davidclifford/CSCvon8/VGA2/finch.png

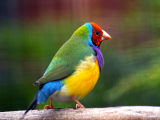
VGA2/finch.png
