davidclifford/CSCvon8/VGA2/forest-glade.png

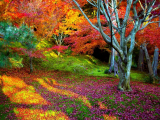
VGA2/forest-glade.png
