davidclifford/CSCvon8/VGA2/gf4.png

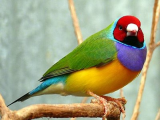
VGA2/gf4.png
