davidclifford/CSCvon8/VGA2/rainbow-cat.png

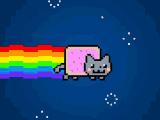
VGA2/rainbow-cat.png
