davidclifford/CSCvon8/VGA2/rainbow-cat/7cf7837815ab4ba79768796c320089a5bYWLsTBWLWjMLtxD-1.png

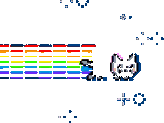
VGA2/rainbow-cat/7cf7837815ab4ba79768796c320089a5bYWLsTBWLWjMLtxD-1.png
