davidclifford/CSCvon8/VGA2/random.png

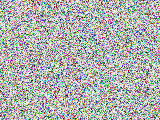
VGA2/random.png
