davidclifford/CSCvon8/VGA2/tenor.gif

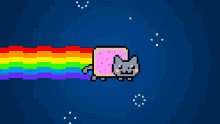
VGA2/tenor.gif
