davidclifford/CSCvon8/VGA2/trippy.png

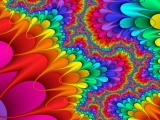
VGA2/trippy.png
