davidclifford/CSCvon8/VGA2/vga_self.png

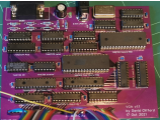
VGA2/vga_self.png
