davidclifford/CSCvon8/VGA5/cat2.gif

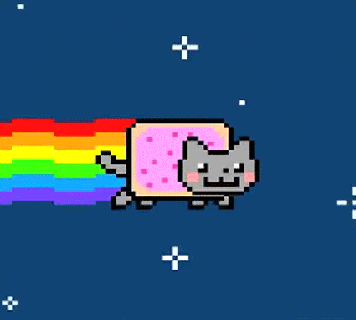
VGA5/cat2.gif
