davidclifford/CSCvon8/VGA5/cat.gif

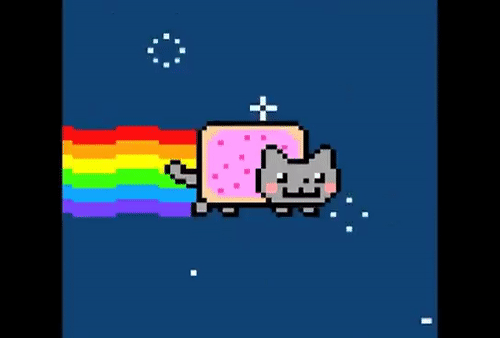
VGA5/cat.gif
