davidclifford/CSCvon8/VGA5/cookie.png

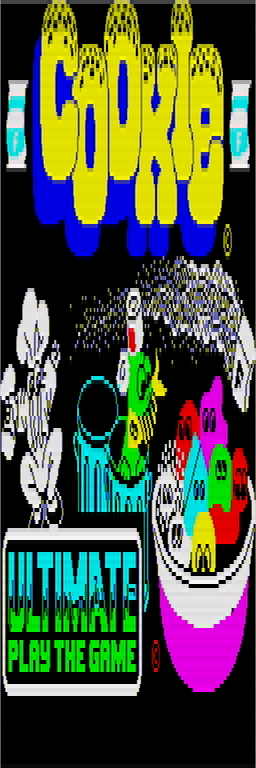
VGA5/cookie.png
