davidclifford/CSCvon8/VGA5/hobbit.png

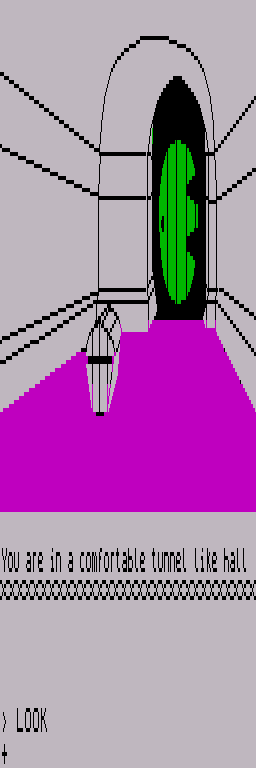
VGA5/hobbit.png
