davidclifford/CSCvon8/VGA5/the-hobbit.png

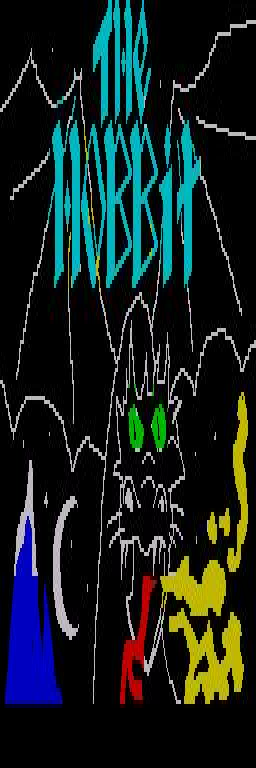
VGA5/the-hobbit.png
