davidclifford/CSCvon8/VGA5/wriggler2.png

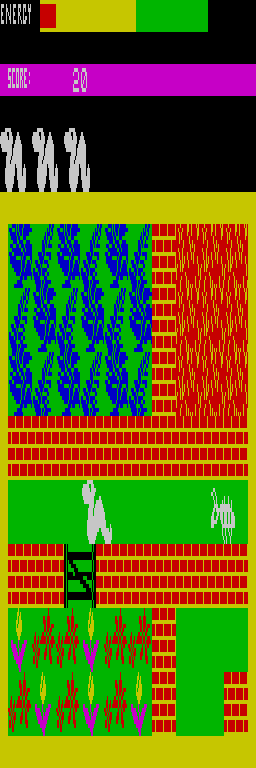
VGA5/wriggler2.png
