davidclifford/CSCvon8/VGA/3parrots.png

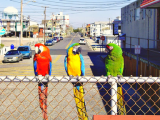
VGA/3parrots.png
