davidclifford/CSCvon8/VGA/alex-mono.png

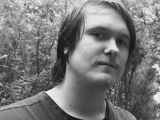
VGA/alex-mono.png
