davidclifford/CSCvon8/VGA/banana.png

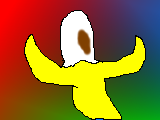
VGA/banana.png
