davidclifford/CSCvon8/VGA/breadboard_vga.jpg

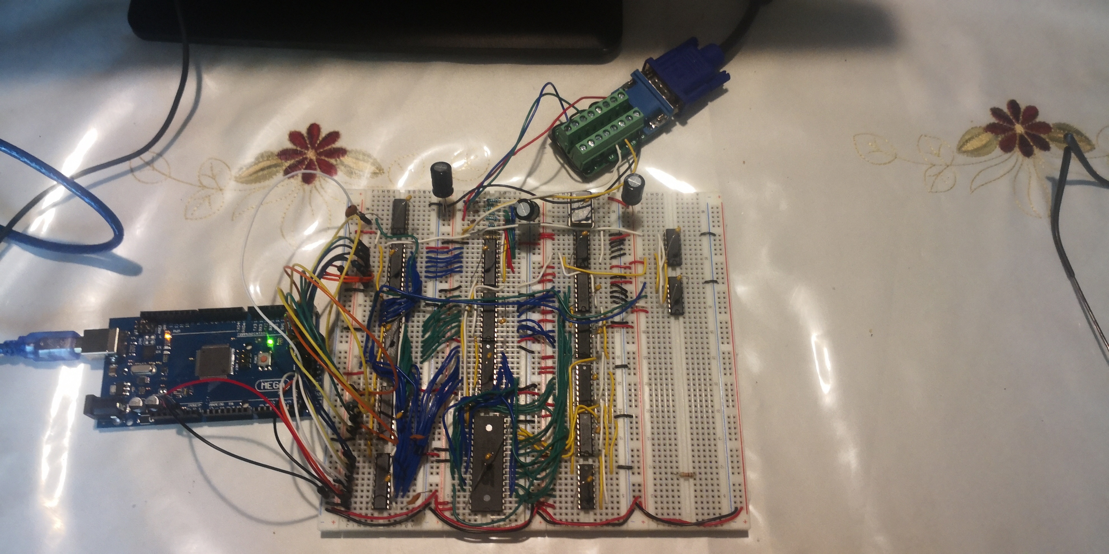
VGA/breadboard_vga.jpg
