davidclifford/CSCvon8/VGA/colours.jpg

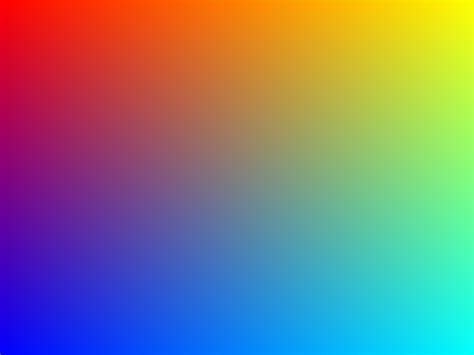
VGA/colours.jpg
