davidclifford/CSCvon8/VGA/dave.jpg

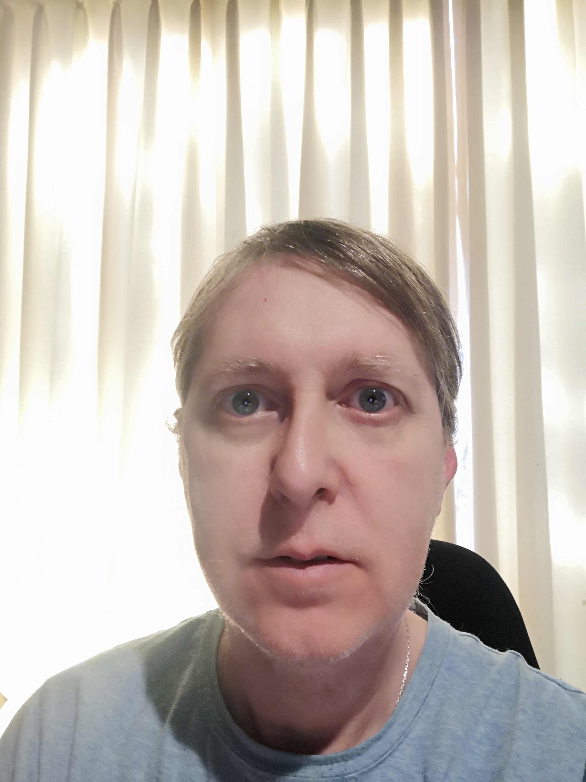
VGA/dave.jpg
