davidclifford/CSCvon8/VGA/dave.png

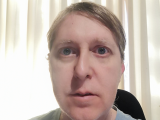
VGA/dave.png
