davidclifford/CSCvon8/VGA/gf5.jpg

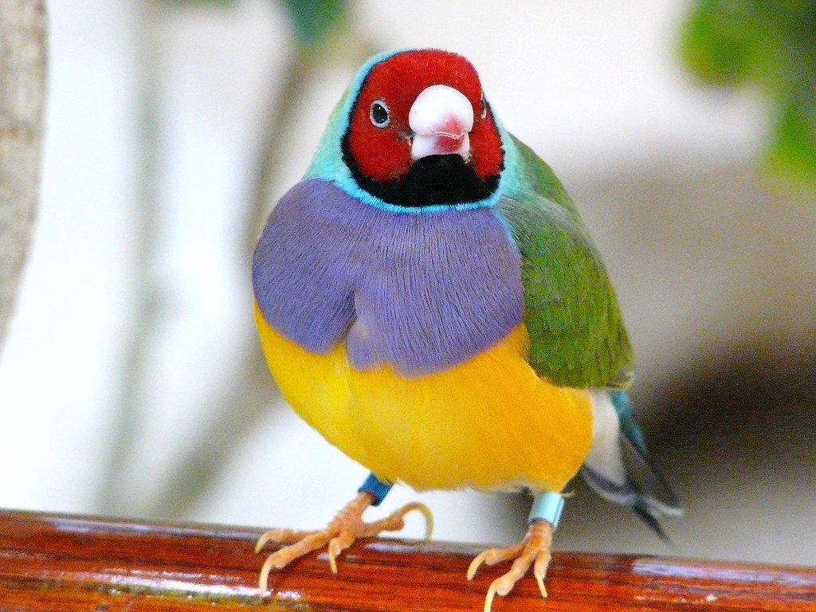
VGA/gf5.jpg
