davidclifford/CSCvon8/VGA/giga-mand.png

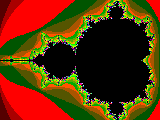
VGA/giga-mand.png
