davidclifford/CSCvon8/VGA/gigatron.png

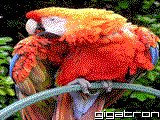
VGA/gigatron.png
