davidclifford/CSCvon8/VGA/parrot3.png

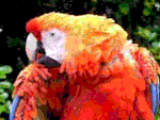
VGA/parrot3.png
