davidclifford/CSCvon8/VGA/parrot.png

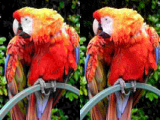
VGA/parrot.png
