davidclifford/CSCvon8/VGA/pic.png

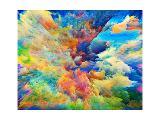
VGA/pic.png
