davidclifford/CSCvon8/VGA/rl2.png

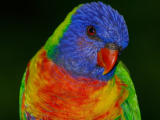
VGA/rl2.png
