davidclifford/CSCvon8/VGA/rl.png

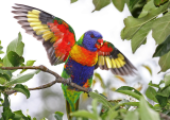
VGA/rl.png
