davidclifford/CSCvon8/VGA/Tetris_Opener.jpg

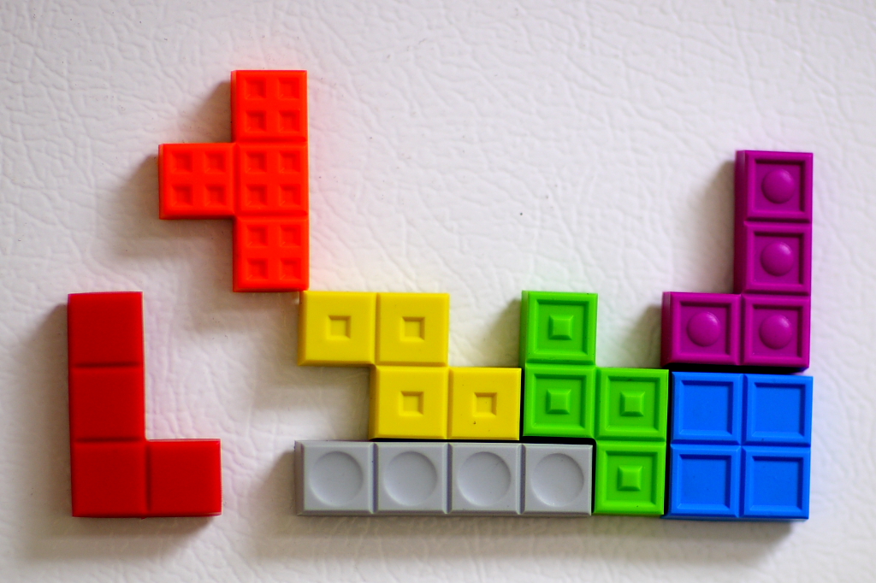
VGA/Tetris_Opener.jpg
