davidclifford/CSCvon8/VGA/vga_bb.jpg

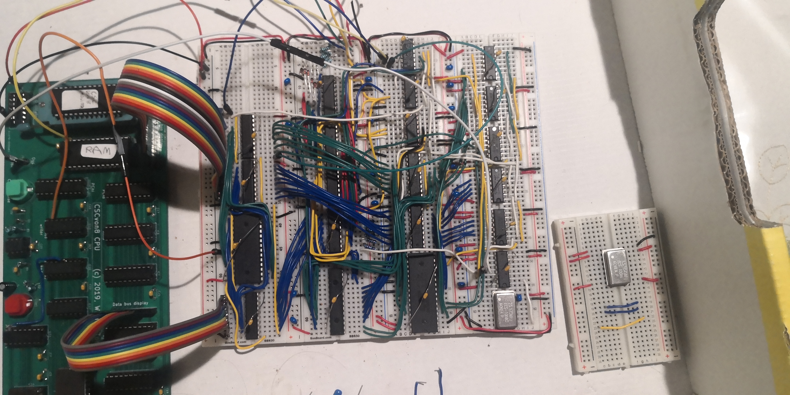
VGA/vga_bb.jpg
