davidclifford/CSCvon8/VGA/vga_bb.png

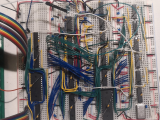
VGA/vga_bb.png
