davidclifford/CSCvon8/VGA2/BOM_PCB_VGA with RAM_2021-09-06.csv

ID | Name | Designator | Footprint | Quantity | Manufacturer Part | Manufacturer | Supplier | Supplier Part | Price
1 | 100n | C1,C2,C3,C4,C5,C6,C7,C8,C9,C10,C11,C12,C14,C15,C16,C17,C18,C19,C20,C21,C22 | RAD-0.1 | 21
2 | 100u | C13 | CAP-D10.0×F5.0 | 1
3 | 1-1734530-3 | DSUB1 | DSUB-15P-22.0X30.8-H12.5-TE | 1 | 1-1734530-3 | TE Connectivity | LCSC | C306051 | 2.015
4 | Address Bus | H1 | HDR-F-2.54_1X16 | 1 |  |  | LCSC | C66987 | 0.095
5 | Data Bus | H2 | HDR-F-2.54_1X8 | 1 |  |  | LCSC | C225505 | 0.155
6 | Pwr + Ctrl | H3 | HDR-F-2.54_1X6 | 1 |  |  | LCSC | C40877 | 0.059
7 | 1.5K | R1,R3,R5 | RES-TH_BD2.3-L6.5-P10.50-D0.5 | 3 | RN1/2WS1.5KΩFT/BA1 | TyoHM | LCSC | C385434 | 0.011
8 | 750 | R2,R4,R6 | RES-TH_BD2.2-L6.5-P10.50-D0.6 | 3 | CF1/4W-750Ω±5% T52 | CCO | LCSC | C120052 | 0.005
9 | 68 | R7,R8 | RES-TH_BD2.4-L6.3-P10.30-D0.6 | 2 | RD 1/4W 68R J T/B A1 | TyoHM | LCSC | C433699 | 0.007
10 | 74HCT163 Master clock | U1 | DIP16 | 1
11 | 74HCT161 X count low | U2 | DIP16 | 1
12 | 74HCT161 X count high | U3 | DIP16 | 1
13 | 74HCT161 Y count low | U4 | DIP16 | 1
14 | 74HCT161 Y count mid | U5 | DIP16 | 1
15 | 74HCT161 Y count high | U6 | DIP16 | 1
16 | SN74LS173AN | U17 | DIP16 | 1
17 | 39SF010 Control ROM | U7 | DIP32-600 | 1
18 | 39SF010 Pixel Control ROM | U18 | DIP32-600 | 1
19 | 74HCT245 Y count buffer | U8 | DIP-20_L25.5-W10.0-P2.54-LS7.6-BL | 1 | SN74LS245N | Texas Instruments | LCSC | C352966 | 0.661
20 | 74HCT245 X count buffer | U10 | DIP-20_L25.5-W10.0-P2.54-LS7.6-BL | 1 | SN74LS245N | Texas Instruments | LCSC | C352966 | 0.661
21 | DM74LS574N Pixel | U9 | DIP20 | 1
22 | 74HCT574 Y coord reg | U12 | DIP20 | 1
23 | 74HCT574 X coord reg | U13 | DIP20 | 1
24 | 74HCT574 Pixel reg | U14 | DIP20 | 1
25 | DM74LS574N Background | U19 | DIP20 | 1
26 | 71256SA15TPG Video mem | U11 | DIP28-300 | 1
27 | 71256SA15TPG Alt Video mem | U21 | DIP28-300 | 1
28 | 74HCT04 Inverter | U15 | DIP-14_L19.0-W7.0-P2.54-LS7.6-BL | 1 | SN74HCT04N | TI | LCSC | C50939 | 0.197
29 | 74HCT32 OR | U16 | DIP-14_L19.0-W7.0-P2.54-LS7.6-BL | 1 | SN74HC32N | TI | LCSC | C2894 | 0.282
30 | 2.1MMJACKTHM | U20 | PJ-102A | 1
31 | 27.175MHz | X1 | OSCILLATOR_DIP-14 | 1
