davidclifford/CSCvon8/VGA/8bit-testcard.jpg

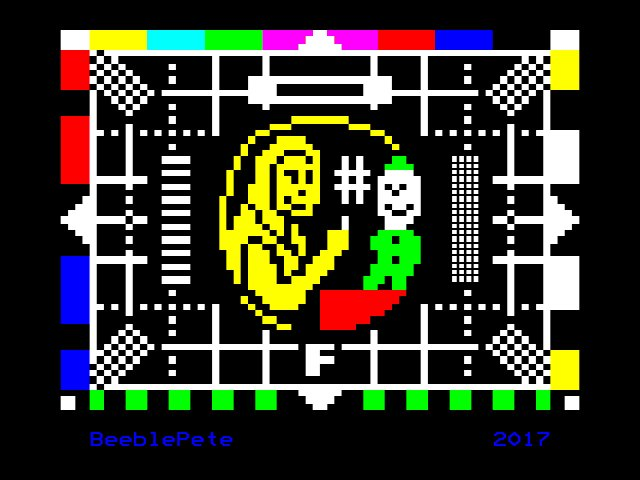
VGA/8bit-testcard.jpg
