davidclifford/CSCvon8/VGA/test.png

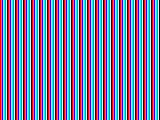
VGA/test.png
