davidclifford/CSCvon8/VGA/testcard.jpg

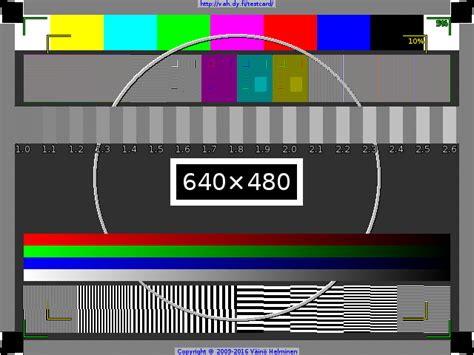
VGA/testcard.jpg
