davidclifford/CSCvon8/VGA2/Schematic_VGA with RAM.pdf

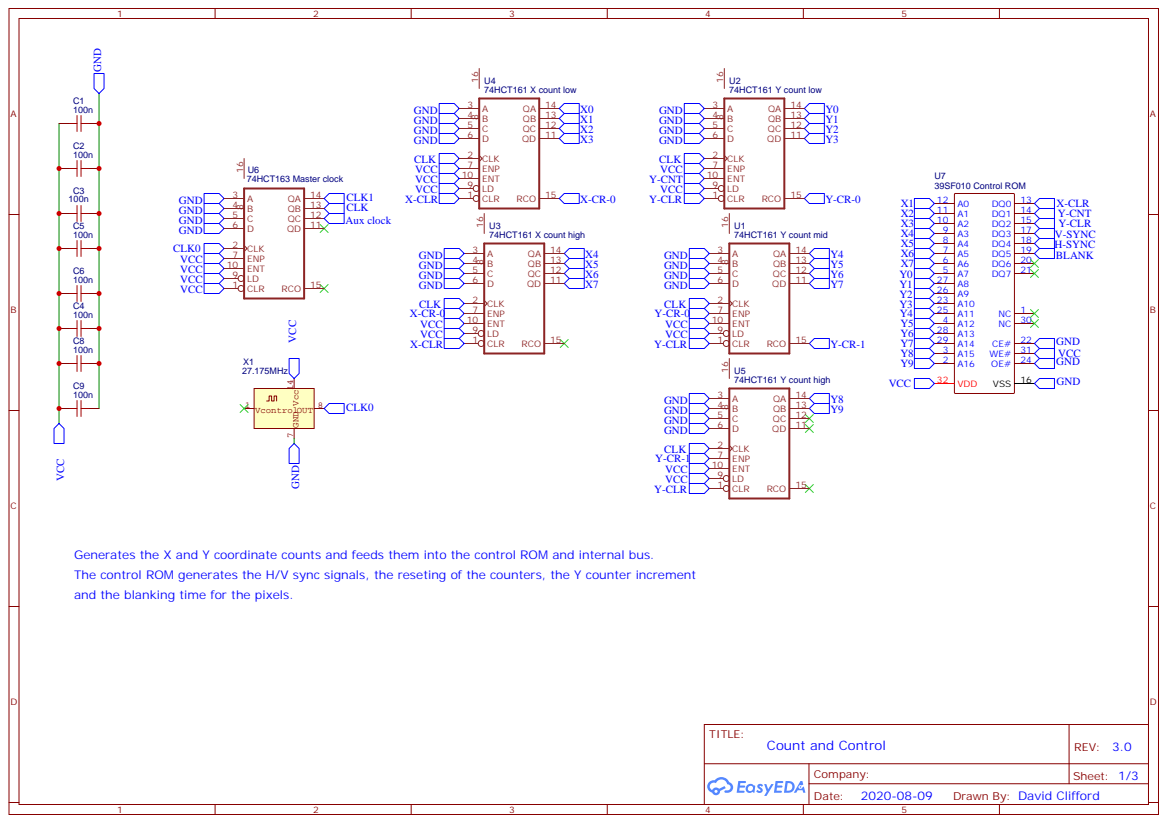
[picture p74: page 1]

Generates the X and Y coordinate counts and feeds them into the control ROM and internal bus.
The control ROM generates the H/V sync signals, the reseting of the counters, the Y counter increment
and the blanking time for the pixels.

Drawn By: David Clifford

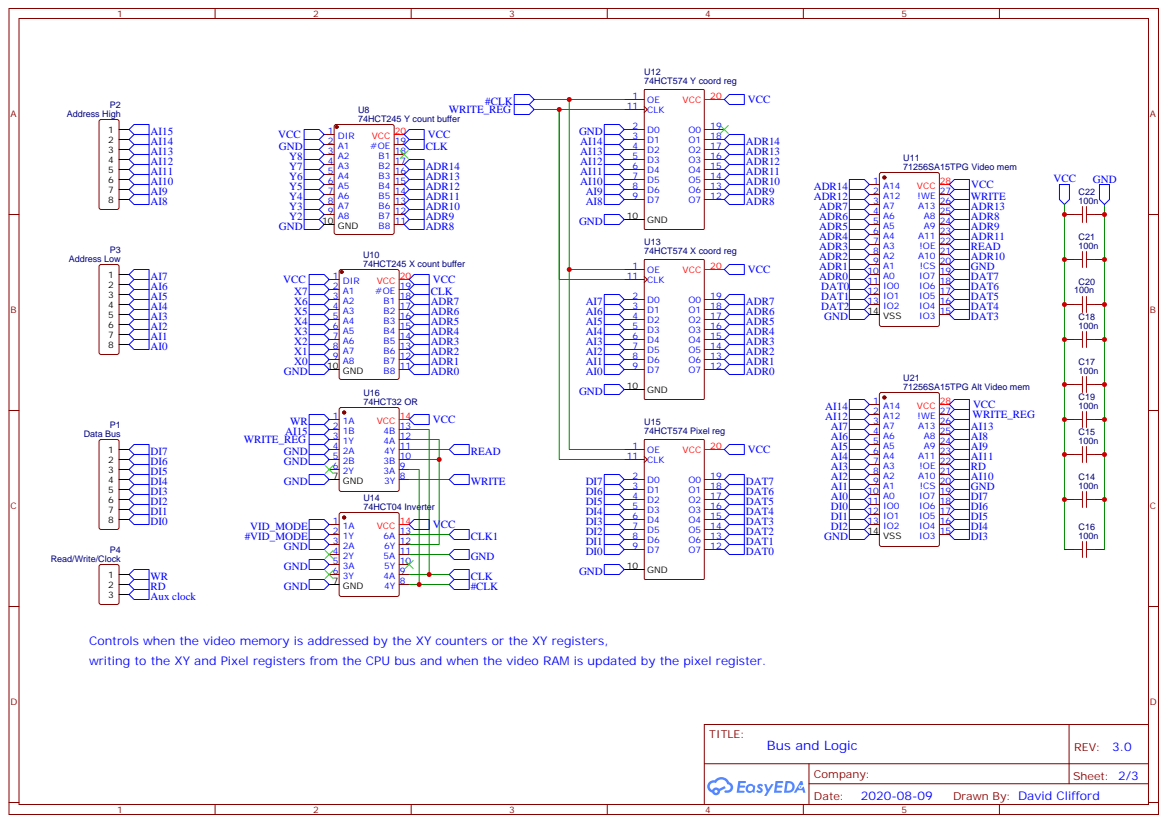
[picture p75: page 2]

Controls when the video memory is addressed by the XY counters or the XY registers,
writing to the XY and Pixel registers from the CPU bus and when the video RAM is updated by the pixel register.

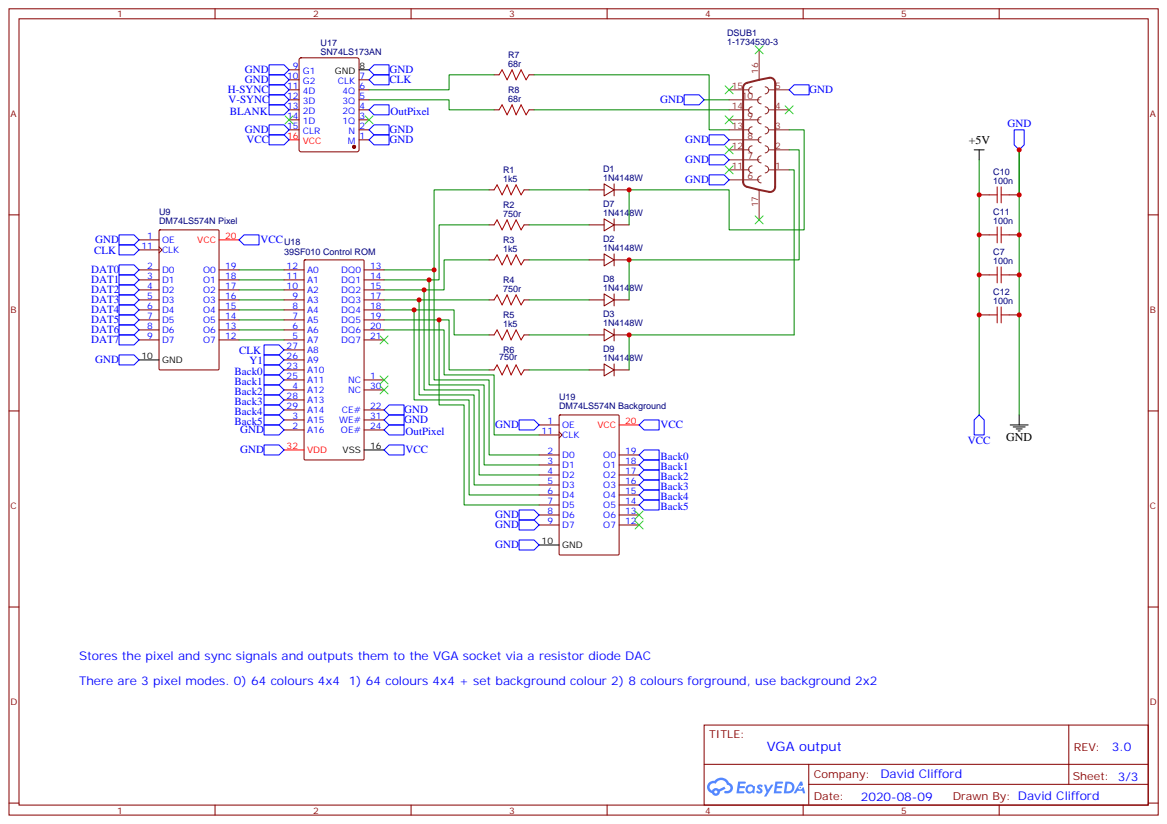
[picture p76: page 3]

Stores the pixel and sync signals and outputs them to the VGA socket via a resistor diode DAC
There are 3 pixel modes. 0) 64 colours 4x4 1) 64 colours 4x4 + set background colour 2) 8 colours forground, use background 2x2
