davidclifford/CSCvon8/Schematic v2/Schematic.kicad_pcb

## KiCad design Schematic v2/Schematic.kicad_pcb (2019-11-12)

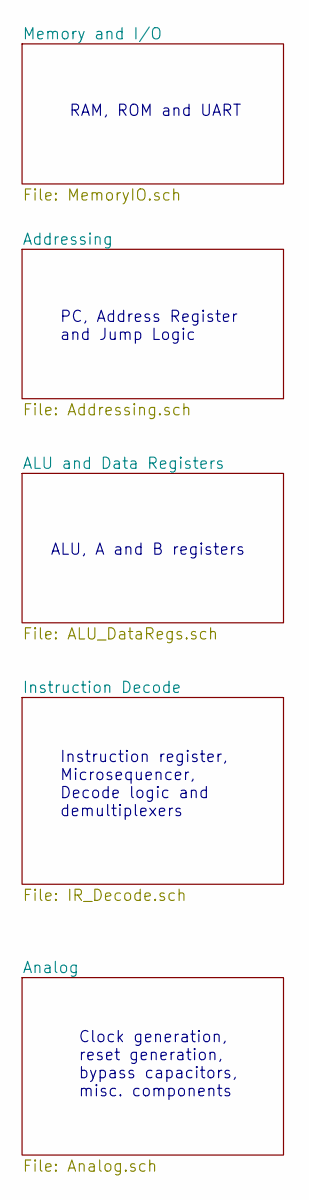
[picture p77: schematic Schematic.sch, CSCvon8 CPU]

Notes on the sheet:
RAM, ROM and UART
PC, Address Register and Jump Logic
ALU, A and B registers
Instruction register, Microsequencer, Decode logic and demultiplexers
Clock generation, reset generation, bypass capacitors, misc. components

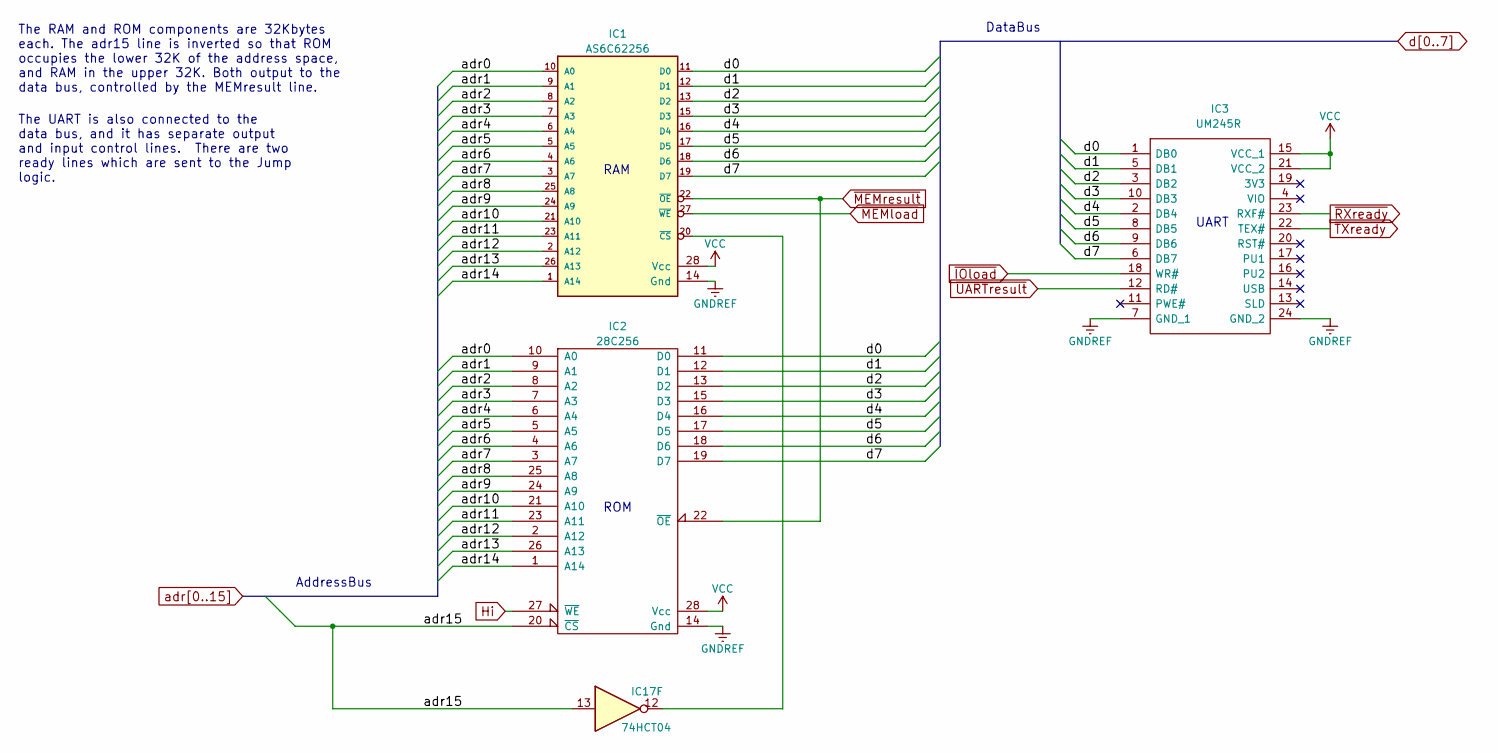
[picture p78: schematic MemoryIO.sch]

Parts:
IC1: AS6C62256; DIP-28_W15.24mm_Socket
IC2: 28C256; DIP-28_W15.24mm_Socket
IC3: UM245R; DIP-24_W15.24mm_Socket; Manufacturer_Part_Number UM245R; Mouser Part Number 895-UM245R
IC17: 74HCT04; DIP-14_W7.62mm_Socket

Connections:
Hi: IC1.28 (Vcc), IC2.27 (~WE), IC2.28 (Vcc), IC3.15 (VCC_1), IC3.21 (VCC_2); also elsewhere on the board
unnamed: IC1.20 (~CS), IC17.12
adr0: IC1.10 (A0), IC2.10 (A0); also elsewhere on the board
adr1: IC1.9 (A1), IC2.9 (A1); also elsewhere on the board
adr2: IC1.8 (A2), IC2.8 (A2); also elsewhere on the board
adr3: IC1.7 (A3), IC2.7 (A3); also elsewhere on the board
adr4: IC1.6 (A4), IC2.6 (A4); also elsewhere on the board
adr5: IC1.5 (A5), IC2.5 (A5); also elsewhere on the board
adr6: IC1.4 (A6), IC2.4 (A6); also elsewhere on the board
adr7: IC1.3 (A7), IC2.3 (A7); also elsewhere on the board
adr8: IC1.25 (A8), IC2.25 (A8); also elsewhere on the board
adr9: IC1.24 (A9), IC2.24 (A9); also elsewhere on the board
adr10: IC1.21 (A10), IC2.21 (A10); also elsewhere on the board
adr11: IC1.23 (A11), IC2.23 (A11); also elsewhere on the board
adr12: IC1.2 (A12), IC2.2 (A12); also elsewhere on the board
adr13: IC1.26 (A13), IC2.26 (A13); also elsewhere on the board
adr14: IC1.1 (A14), IC2.1 (A14); also elsewhere on the board
adr15: IC2.20 (~CS), IC17.13; also elsewhere on the board
d0: IC1.11 (D0), IC2.11 (D0), IC3.1 (DB0); also elsewhere on the board
d1: IC1.12 (D1), IC2.12 (D1), IC3.5 (DB1); also elsewhere on the board
d2: IC1.13 (D2), IC2.13 (D2), IC3.3 (DB2); also elsewhere on the board
d3: IC1.15 (D3), IC2.15 (D3), IC3.10 (DB3); also elsewhere on the board
d4: IC1.16 (D4), IC2.16 (D4), IC3.2 (DB4); also elsewhere on the board
d5: IC1.17 (D5), IC2.17 (D5), IC3.8 (DB5); also elsewhere on the board
d6: IC1.18 (D6), IC2.18 (D6), IC3.9 (DB6); also elsewhere on the board
d7: IC1.19 (D7), IC2.19 (D7), IC3.6 (DB7); also elsewhere on the board
~IOload: IC3.18 (WR#); also elsewhere on the board
~MEMload: IC1.27 (~WE); also elsewhere on the board
~MEMresult: IC1.22 (~OE), IC2.22 (~OE); also elsewhere on the board
~RXready: IC3.23 (RXF#); also elsewhere on the board
~TXready: IC3.22 (TEX#); also elsewhere on the board
~UARTresult: IC3.12 (RD#); also elsewhere on the board

Notes on the sheet:
RAM
ROM
UART
AddressBus
DataBus
The RAM and ROM components are 32Kbytes each. The adr15 line is inverted so that ROM occupies the lower 32K of the address space, and RAM in the upper 32K. Both output to the data bus, controlled by the MEMresult line.
The UART is also connected to the data bus, and it has separate output and input control lines. There are two ready lines which are sent to the Jump logic.

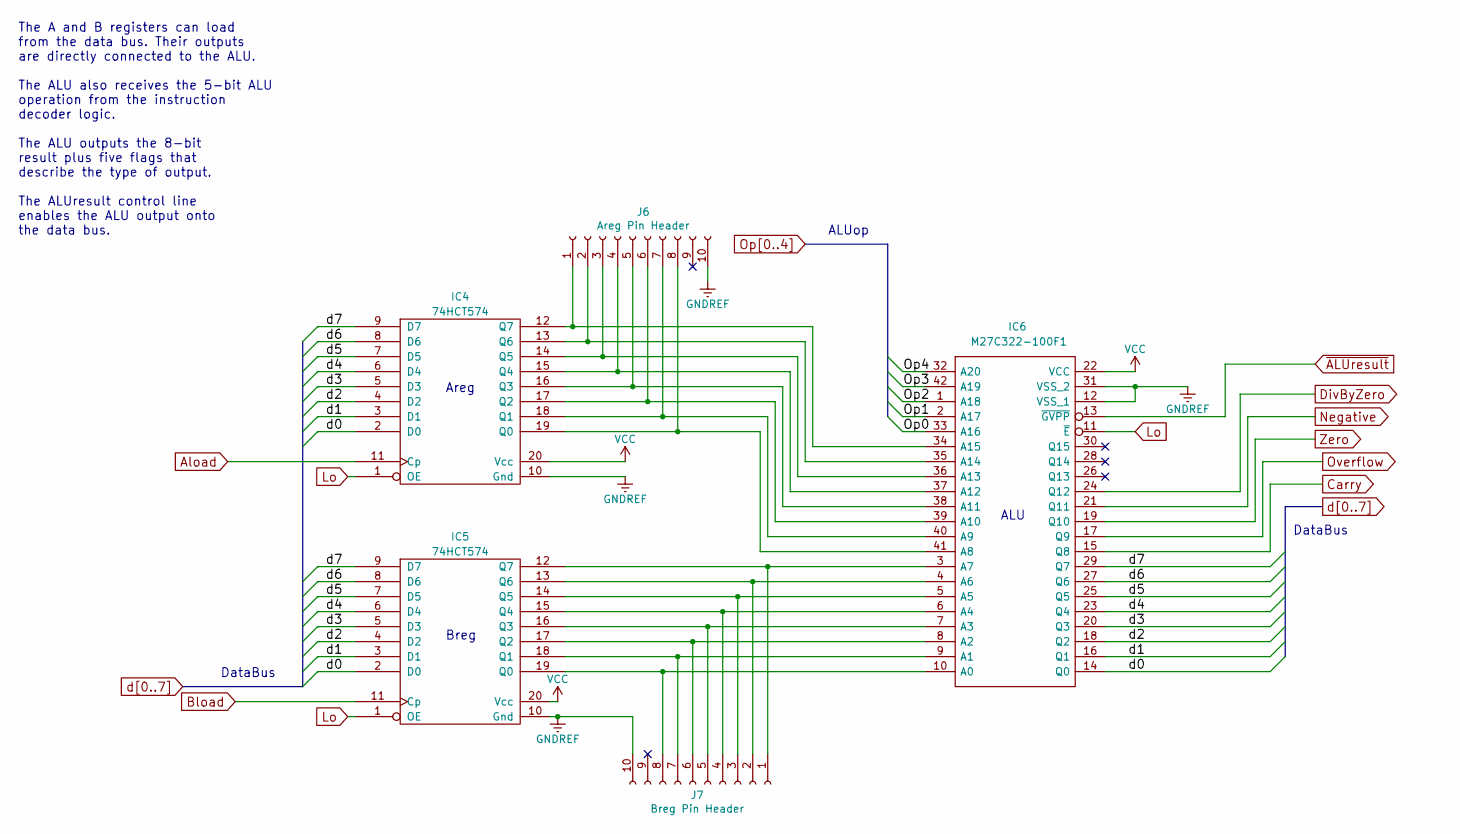
[picture p79: schematic ALU_DataRegs.sch]

Parts:
IC4, IC5: 74HCT574; DIP-20_W7.62mm_Socket
IC6: M27C322-100F1; DIP-42_W15.24mm_Socket; Manufacturer_Part_Number M27C322-100F1; Mouser Part Number 511-M27C322-10F
J6: Areg Pin Header; PinSocket_1x10_P2.54mm_Vertical
J7: Breg Pin Header; PinSocket_1x10_P2.54mm_Vertical

Connections:
Aload: IC4.11 (Cp); also elsewhere on the board
Bload: IC5.11 (Cp); also elsewhere on the board
Carry: IC6.15 (Q8); also elsewhere on the board
DivByZero: IC6.24 (Q12); also elsewhere on the board
Hi: IC4.20 (Vcc), IC5.20 (Vcc), IC6.22 (VCC); also elsewhere on the board
Negative: IC6.21 (Q11); also elsewhere on the board
unnamed: IC4.12 (Q7), IC6.34 (A15), J6.1
unnamed: IC4.13 (Q6), IC6.35 (A14), J6.2
unnamed: IC4.14 (Q5), IC6.36 (A13), J6.3
unnamed: IC4.15 (Q4), IC6.37 (A12), J6.4
unnamed: IC4.16 (Q3), IC6.38 (A11), J6.5
unnamed: IC4.17 (Q2), IC6.39 (A10), J6.6
unnamed: IC4.18 (Q1), IC6.40 (A9), J6.7
unnamed: IC4.19 (Q0), IC6.41 (A8), J6.8
unnamed: IC5.12 (Q7), IC6.3 (A7), J7.1
unnamed: IC5.13 (Q6), IC6.4 (A6), J7.2
unnamed: IC5.14 (Q5), IC6.5 (A5), J7.3
unnamed: IC5.15 (Q4), IC6.6 (A4), J7.4
unnamed: IC5.16 (Q3), IC6.7 (A3), J7.5
unnamed: IC5.17 (Q2), IC6.8 (A2), J7.6
unnamed: IC5.18 (Q1), IC6.9 (A1), J7.7
unnamed: IC5.19 (Q0), IC6.10 (A0), J7.8
Op0: IC6.33 (A16); also elsewhere on the board
Op1: IC6.2 (A17); also elsewhere on the board
Op2: IC6.1 (A18); also elsewhere on the board
Op3: IC6.42 (A19); also elsewhere on the board
Op4: IC6.32 (A20); also elsewhere on the board
Overflow: IC6.17 (Q9); also elsewhere on the board
Zero: IC6.19 (Q10); also elsewhere on the board
d0: IC4.2 (D0), IC5.2 (D0), IC6.14 (Q0); also elsewhere on the board
d1: IC4.3 (D1), IC5.3 (D1), IC6.16 (Q1); also elsewhere on the board
d2: IC4.4 (D2), IC5.4 (D2), IC6.18 (Q2); also elsewhere on the board
d3: IC4.5 (D3), IC5.5 (D3), IC6.20 (Q3); also elsewhere on the board
d4: IC4.6 (D4), IC5.6 (D4), IC6.23 (Q4); also elsewhere on the board
d5: IC4.7 (D5), IC5.7 (D5), IC6.25 (Q5); also elsewhere on the board
d6: IC4.8 (D6), IC5.8 (D6), IC6.27 (Q6); also elsewhere on the board
d7: IC4.9 (D7), IC5.9 (D7), IC6.29 (Q7); also elsewhere on the board
~ALUresult: IC6.13 (~GVPP); also elsewhere on the board

Notes on the sheet:
ALU
Areg
Breg
DataBus
ALUop
The A and B registers can load from the data bus. Their outputs are directly connected to the ALU. The ALU also receives the 5-bit ALU operation from the instruction decoder logic. The ALU outputs the 8-bit result plus five flags that describe the type of output. The ALUresult control line enables 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

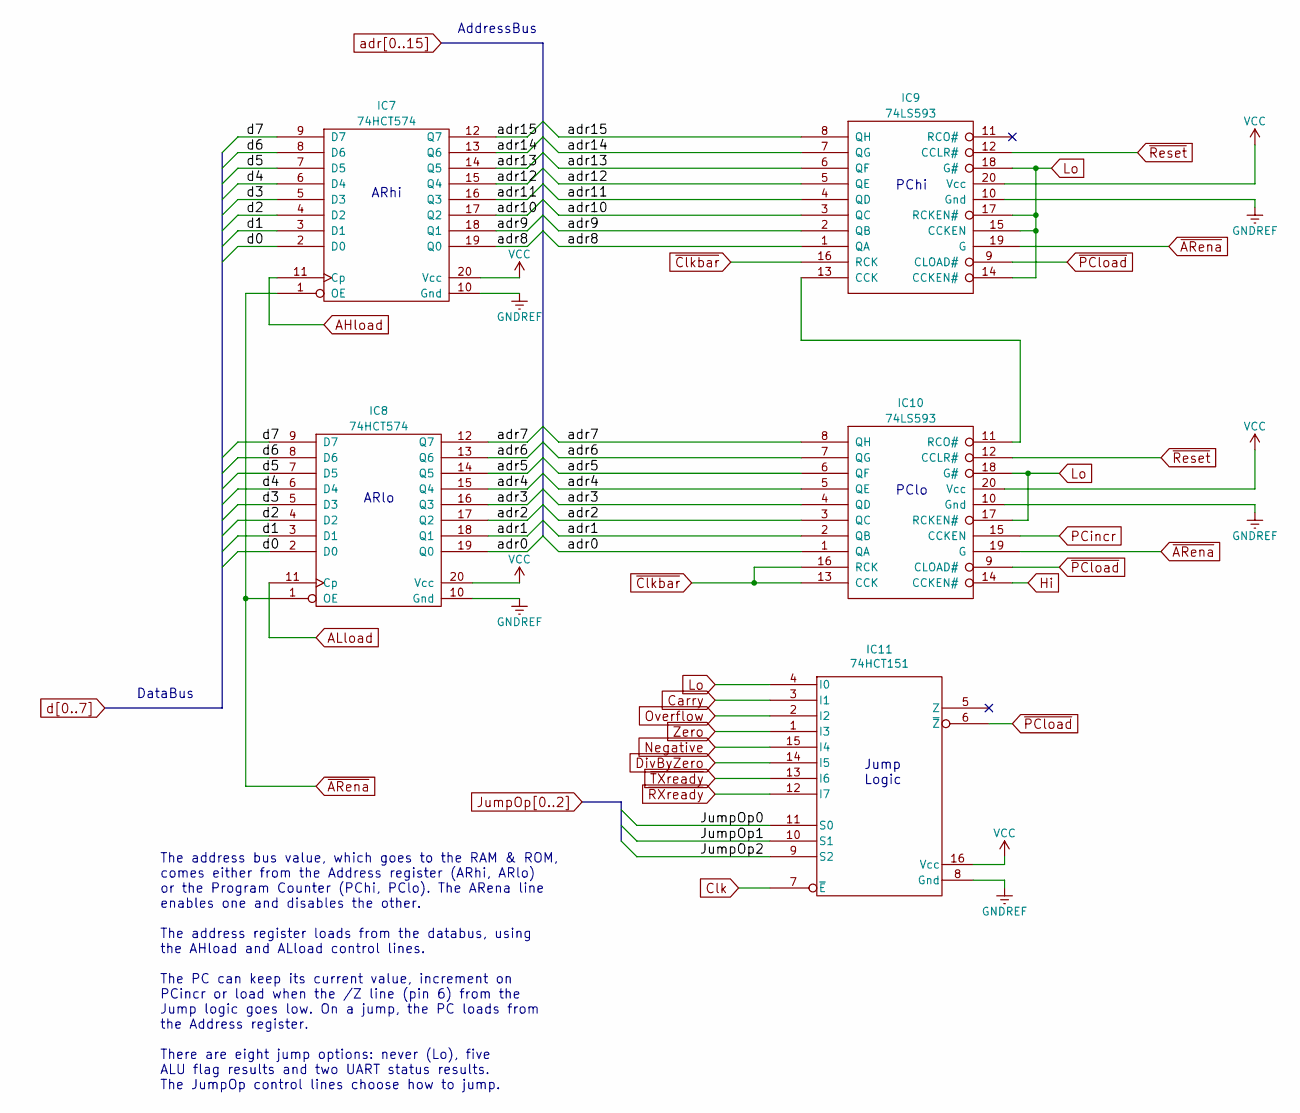
[picture p80: schematic Addressing.sch]

Parts:
IC7, IC8: 74HCT574; DIP-20_W7.62mm_Socket
IC9, IC10: 74LS593; DIP-20_W7.62mm_Socket
IC11: 74HCT151; DIP-16_W7.62mm_Socket

Connections:
AHload: IC7.11 (Cp); also elsewhere on the board
ALload: IC8.11 (Cp); also elsewhere on the board
Carry: IC11.3 (I1); also elsewhere on the board
Clk: IC11.7 (~E); also elsewhere on the board
DivByZero: IC11.14 (I5); also elsewhere on the board
Hi: IC7.20 (Vcc), IC8.20 (Vcc), IC9.20 (Vcc), IC10.14 (CCKEN#), IC10.20 (Vcc), IC11.16 (Vcc); also elsewhere on the board
JumpOp0: IC11.11 (S0); also elsewhere on the board
JumpOp1: IC11.10 (S1); also elsewhere on the board
JumpOp2: IC11.9 (S2); also elsewhere on the board
Negative: IC11.15 (I4); also elsewhere on the board
unnamed: IC9.13 (CCK), IC10.11 (RCO#)
Overflow: IC11.2 (I2); also elsewhere on the board
PCincr: IC10.15 (CCKEN); also elsewhere on the board
Zero: IC11.1 (I3); also elsewhere on the board
adr0: IC8.19 (Q0), IC10.1 (QA); also elsewhere on the board
adr1: IC8.18 (Q1), IC10.2 (QB); also elsewhere on the board
adr2: IC8.17 (Q2), IC10.3 (QC); also elsewhere on the board
adr3: IC8.16 (Q3), IC10.4 (QD); also elsewhere on the board
adr4: IC8.15 (Q4), IC10.5 (QE); also elsewhere on the board
adr5: IC8.14 (Q5), IC10.6 (QF); also elsewhere on the board
adr6: IC8.13 (Q6), IC10.7 (QG); also elsewhere on the board
adr7: IC8.12 (Q7), IC10.8 (QH); also elsewhere on the board
adr8: IC7.19 (Q0), IC9.1 (QA); also elsewhere on the board
adr9: IC7.18 (Q1), IC9.2 (QB); also elsewhere on the board
adr10: IC7.17 (Q2), IC9.3 (QC); also elsewhere on the board
adr11: IC7.16 (Q3), IC9.4 (QD); also elsewhere on the board
adr12: IC7.15 (Q4), IC9.5 (QE); also elsewhere on the board
adr13: IC7.14 (Q5), IC9.6 (QF); also elsewhere on the board
adr14: IC7.13 (Q6), IC9.7 (QG); also elsewhere on the board
adr15: IC7.12 (Q7), IC9.8 (QH); also elsewhere on the board
d0: IC7.2 (D0), IC8.2 (D0); also elsewhere on the board
d1: IC7.3 (D1), IC8.3 (D1); also elsewhere on the board
d2: IC7.4 (D2), IC8.4 (D2); also elsewhere on the board
d3: IC7.5 (D3), IC8.5 (D3); also elsewhere on the board
d4: IC7.6 (D4), IC8.6 (D4); also elsewhere on the board
d5: IC7.7 (D5), IC8.7 (D5); also elsewhere on the board
d6: IC7.8 (D6), IC8.8 (D6); also elsewhere on the board
d7: IC7.9 (D7), IC8.9 (D7); also elsewhere on the board
~ARena: IC7.1 (OE), IC8.1 (OE), IC9.19 (G), IC10.19 (G); also elsewhere on the board
~Clkbar: IC9.16 (RCK), IC10.13 (CCK), IC10.16 (RCK); also elsewhere on the board
~PCload: IC9.9 (CLOAD#), IC10.9 (CLOAD#), IC11.6 (~Z)
~RXready: IC11.12 (I7); also elsewhere on the board
~Reset: IC9.12 (CCLR#), IC10.12 (CCLR#); also elsewhere on the board
~TXready: IC11.13 (I6); also elsewhere on the board

Notes on the sheet:
Jump Logic
ARhi
ARlo
PChi
PClo
DataBus
AddressBus
The address bus value, which goes to the RAM & ROM, comes either from the Address register (ARhi, ARlo) or the Program Counter (PChi, PClo). The ARena line enables one and disables the other. The address register loads from the databus, using the AHload and ALload control lines. The PC can keep its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

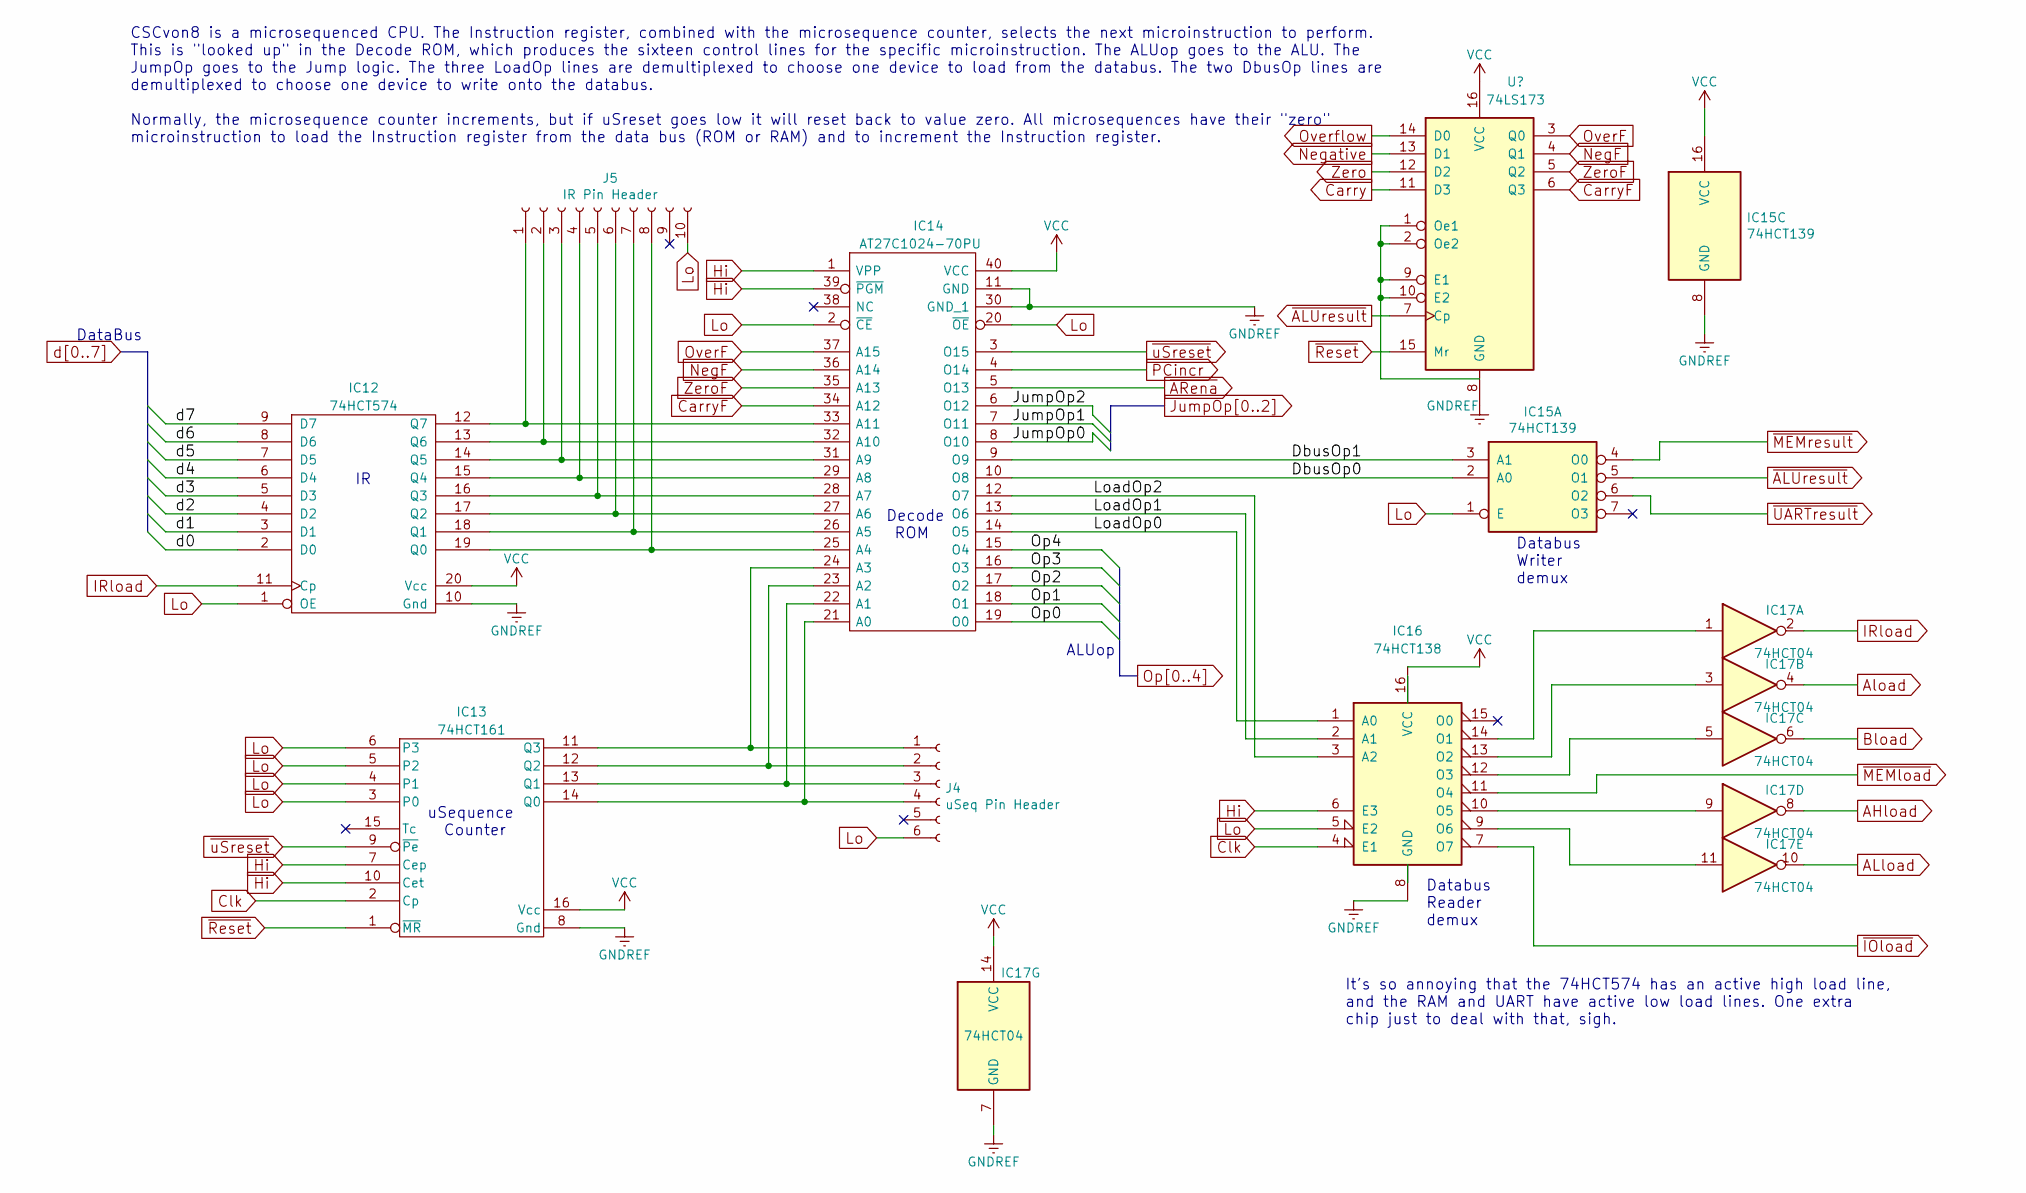
[picture p81: schematic IR_Decode.sch]

Parts:
IC12: 74HCT574; DIP-20_W7.62mm_Socket
IC13: 74HCT161; DIP-16_W7.62mm_Socket
IC14: AT27C1024-70PU; DIP-40_W15.24mm_Socket; Manufacturer_Part_Number AT27C1024-70PU; Mouser Part Number 556-AT27C102470PU
IC15: 74HCT139; DIP-16_W7.62mm_Socket
IC16: 74HCT138; DIP-16_W7.62mm_Socket
IC17: 74HCT04; DIP-14_W7.62mm_Socket
J4: uSeq Pin Header; PinSocket_1x06_P2.54mm_Vertical
J5: IR Pin Header; PinSocket_1x10_P2.54mm_Vertical

Connections:
/Instruction Decode/DbusOp0: IC14.10 (O8), IC15.2 (A0)
/Instruction Decode/DbusOp1: IC14.9 (O9), IC15.3 (A1)
/Instruction Decode/LoadOp0: IC14.14 (O5), IC16.1 (A0)
/Instruction Decode/LoadOp1: IC14.13 (O6), IC16.2 (A1)
/Instruction Decode/LoadOp2: IC14.12 (O7), IC16.3 (A2)
AHload: IC17.8; also elsewhere on the board
ALload: IC17.10; also elsewhere on the board
Aload: IC17.4; also elsewhere on the board
Bload: IC17.6; also elsewhere on the board
Clk: IC13.2 (Cp), IC16.4 (E1); also elsewhere on the board
Hi: IC12.20 (Vcc), IC13.7 (Cep), IC13.10 (Cet), IC13.16 (Vcc), IC14.1 (VPP), IC14.39 (~PGM), IC14.40 (VCC), IC15.16 (VCC), IC16.6 (E3), IC16.16 (VCC), IC17.14 (VCC); also elsewhere on the board
IRload: IC12.11 (Cp), IC17.2
JumpOp0: IC14.8 (O10); also elsewhere on the board
JumpOp1: IC14.7 (O11); also elsewhere on the board
JumpOp2: IC14.6 (O12); also elsewhere on the board
unnamed: IC12.12 (Q7), IC14.33 (A11), J5.1
unnamed: IC12.13 (Q6), IC14.32 (A10), J5.2
unnamed: IC12.14 (Q5), IC14.31 (A9), J5.3
unnamed: IC12.15 (Q4), IC14.29 (A8), J5.4
unnamed: IC12.16 (Q3), IC14.28 (A7), J5.5
unnamed: IC12.17 (Q2), IC14.27 (A6), J5.6
unnamed: IC12.18 (Q1), IC14.26 (A5), J5.7
unnamed: IC12.19 (Q0), IC14.25 (A4), J5.8
unnamed: IC13.11 (Q3), IC14.24 (A3), J4.1
unnamed: IC13.12 (Q2), IC14.23 (A2), J4.2
unnamed: IC13.13 (Q1), IC14.22 (A1), J4.3
unnamed: IC13.14 (Q0), IC14.21 (A0), J4.4
unnamed: IC16.9 (O6), IC17.11
unnamed: IC16.10 (O5), IC17.9
unnamed: IC16.12 (O3), IC17.5
unnamed: IC16.13 (O2), IC17.3
unnamed: IC16.14 (O1), IC17.1
Op0: IC14.19 (O0); also elsewhere on the board
Op1: IC14.18 (O1); also elsewhere on the board
Op2: IC14.17 (O2); also elsewhere on the board
Op3: IC14.16 (O3); also elsewhere on the board
Op4: IC14.15 (O4); also elsewhere on the board
PCincr: IC14.4 (O14); also elsewhere on the board
d0: IC12.2 (D0); also elsewhere on the board
d1: IC12.3 (D1); also elsewhere on the board
d2: IC12.4 (D2); also elsewhere on the board
d3: IC12.5 (D3); also elsewhere on the board
d4: IC12.6 (D4); also elsewhere on the board
d5: IC12.7 (D5); also elsewhere on the board
d6: IC12.8 (D6); also elsewhere on the board
d7: IC12.9 (D7); also elsewhere on the board
~ALUresult: IC15.5 (O1); also elsewhere on the board
~ARena: IC14.5 (O13); also elsewhere on the board
~IOload: IC16.7 (O7); also elsewhere on the board
~MEMload: IC16.11 (O4); also elsewhere on the board
~MEMresult: IC15.4 (O0); also elsewhere on the board
~Reset: IC13.1 (~MR); also elsewhere on the board
~UARTresult: IC15.6 (O2); also elsewhere on the board
~uSreset: IC13.9 (~Pe), IC14.3 (O15)

Notes on the sheet:
Decode ROM
uSequence Counter
Databus Writer demux
Databus Reader demux
DataBus
ALUop
CSCvon8 is a microsequenced CPU. The Instruction register, combined with the microsequence counter, selects the next microinstruction to perform. This is "looked up" in the Decode ROM, which produces the sixteen control lines for the specific microinstruction. The ALUop goes to the ALU. The JumpOp 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
It's so annoying that the 74HCT574 has an active high load line, and the RAM and UART have active low load lines. One extra chip just to deal with that, sigh.

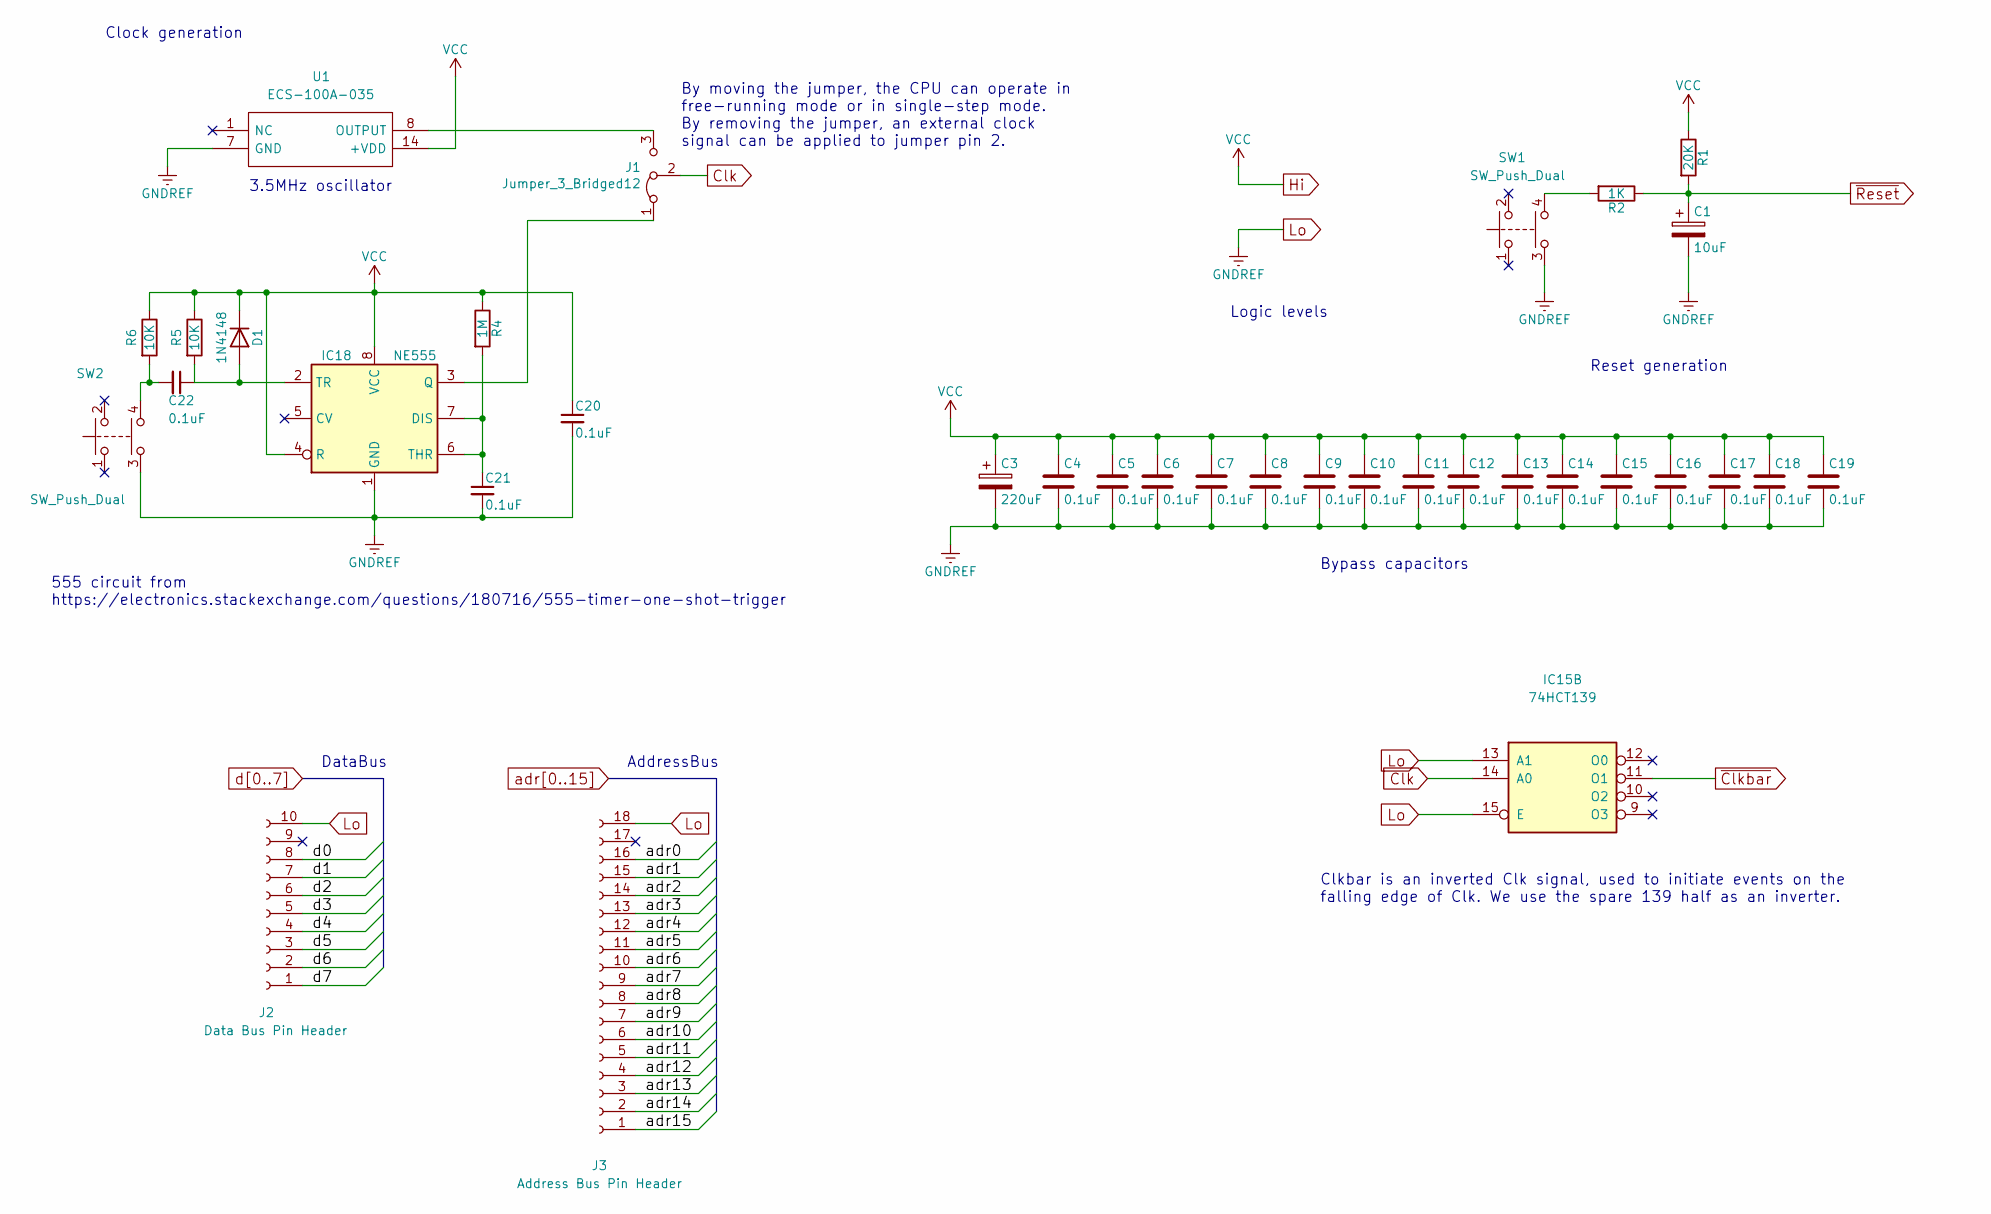
[picture p82: schematic Analog.sch]

Parts:
C1: 10uF; CP_Radial_D5.0mm_P2.00mm
C3: 220uF; CP_Radial_D8.0mm_P5.00mm
C4, C5, C6, C7, C8, C9, C10, C11, C12, C13, C14, C15, C16, C17, C18, C19, C20, C21, C22: 0.1uF; C_Disc_D4.7mm_W2.5mm_P5.00mm
D1: 1N4148; D_DO-35_SOD27_P2.54mm_Vertical_AnodeUp
IC15: 74HCT139; DIP-16_W7.62mm_Socket
IC18: NE555; DIP-8_W7.62mm_Socket
J1: Jumper_3_Bridged12; PinSocket_1x03_P2.54mm_Vertical
J2: Data Bus Pin Header; PinSocket_1x10_P2.54mm_Vertical
J3: Address Bus Pin Header; PinSocket_1x18_P2.54mm_Vertical
R1: 20K; R_Axial_DIN0204_L3.6mm_D1.6mm_P1.90mm_Vertical
R2: 1K; R_Axial_DIN0204_L3.6mm_D1.6mm_P1.90mm_Vertical
R4: 1M; R_Axial_DIN0204_L3.6mm_D1.6mm_P1.90mm_Vertical
R5, R6: 10K; R_Axial_DIN0204_L3.6mm_D1.6mm_P1.90mm_Vertical
SW1, SW2: SW_Push_Dual; Push_E-Switch_KS01Q01
U1: ECS-100A-035; QX14T50B1.843200B50TT; Manufacturer_Part_Number QX14T50B1.843200B50TT

Connections:
Clk: IC15.14 (A0), J1.2 (C); also elsewhere on the board
Hi: C3.1, C4.1, C5.1, C6.1, C7.1, C8.1, C9.1, C10.1, C11.1, C12.1, C13.1, C14.1, C15.1, C16.1, C17.1, C18.1, C19.1, C20.1, D1.1 (K), IC18.4 (R), IC18.8 (VCC), R1.1, R4.1, R5.1, R6.1, U1.14 (+VDD); also elsewhere on the board
unnamed: C21.1, IC18.6 (THR), IC18.7 (DIS), R4.2
unnamed: C22.1, D1.2 (A), IC18.2 (TR), R5.2
unnamed: C22.2, R6.2, SW2.4
unnamed: IC18.3 (Q), J1.1 (A)
unnamed: J1.3 (B), U1.8 (OUTPUT)
unnamed: R2.2, SW1.4
adr0: J3.16; also elsewhere on the board
adr1: J3.15; also elsewhere on the board
adr2: J3.14; also elsewhere on the board
adr3: J3.13; also elsewhere on the board
adr4: J3.12; also elsewhere on the board
adr5: J3.11; also elsewhere on the board
adr6: J3.10; also elsewhere on the board
adr7: J3.9; also elsewhere on the board
adr8: J3.8; also elsewhere on the board
adr9: J3.7; also elsewhere on the board
adr10: J3.6; also elsewhere on the board
adr11: J3.5; also elsewhere on the board
adr12: J3.4; also elsewhere on the board
adr13: J3.3; also elsewhere on the board
adr14: J3.2; also elsewhere on the board
adr15: J3.1; also elsewhere on the board
d0: J2.8; also elsewhere on the board
d1: J2.7; also elsewhere on the board
d2: J2.6; also elsewhere on the board
d3: J2.5; also elsewhere on the board
d4: J2.4; also elsewhere on the board
d5: J2.3; also elsewhere on the board
d6: J2.2; also elsewhere on the board
d7: J2.1; also elsewhere on the board
~Clkbar: IC15.11 (O1); also elsewhere on the board
~Reset: C1.1, R1.2, R2.1; also elsewhere on the board

Notes on the sheet:
By moving the jumper, the CPU can operate in free-running mode or in single-step mode. By removing the jumper, an external clock signal can be applied to jumper pin 2.
3.5MHz oscillator
Bypass capacitors
Reset generation
Clock generation
Logic levels
DataBus
AddressBus
555 circuit from https://electronics.stackexchange.com/questions/180716/555-timer-one-shot-trigger
Clkbar is an inverted Clk signal, used to initiate events on the falling edge of Clk. We use the spare 139 half as an inverter.

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
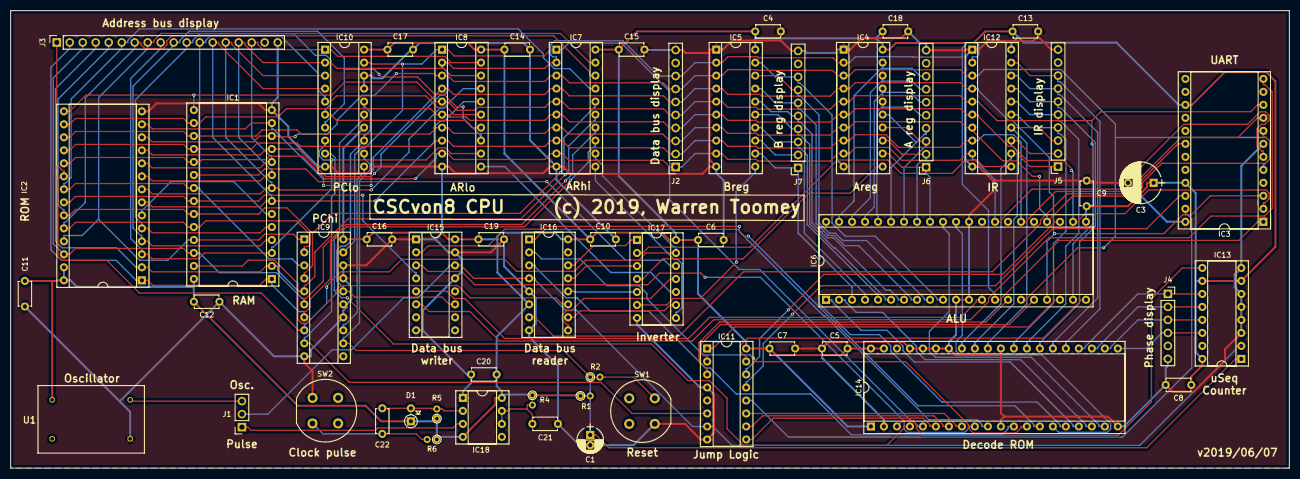
[picture p83: board Schematic.kicad_pcb from above]

Board: 2 copper layers, 249.9 x 89.4 mm, 55 parts (0 on the bottom side), 104 nets.
