davidclifford/CSCvon8/(commit log)

2019-11-12 Fork of CSCvon8
    [ALU_DataRegs.sch, Addressing.sch, Analog.sch, IR_Decode.sch, MemoryIO.sch, Schematic.kicad_pcb, Schematic.sch, bom_20190601.csv]
2019-11-12 print num as an unsigned 8 bit string
2019-12-02 Example Arduino interupt controled monitor
2019-12-07 Show pic in rrggbb format while converting
    [vga.kicad_pcb, vga.sch]
2019-12-08 Start on VGA schematic
    [vga.sch]
2019-12-28 VGA test pics with Arduino MEGA
2020-01-07 Start of printing chars to VGA
2020-01-13 Print strings to VGA
2020-01-14 Print strings on VGA. Control char \n
2020-02-19 Print 16-bit unsigned number (backwards)
2020-03-20 print-16 loop all 16-bit numbers and print out in correct order
2020-04-13 Testris - initialise board, update randomiser and loop for next piece
2020-04-13 Tetris - Add new piece to board
2020-06-19 MONITOR: add system calls for printing in small font
2020-06-26 MONITOR: auto scroll VGA when printing bottom of screen, use colours for monitor
2020-07-12 VGA: Print out text in colour
2020-07-30 Convert examples of div 10 and print 16 to newer cas
2020-07-31 Print 16-bin unsigned number to video
2020-08-09 Mandlebrot and Schematic PDF
2021-01-05 Sudoku solver showing board on VGA
2021-05-24 VGA3 - 400x600@56Hz in 4096 colours
2021-09-18 Prime numbers example
    [BOM_PCB_VGA with RAM_2021-09-06.csv]
2022-06-19 File system - write files & print dir
2022-08-25 file-system: Get ready for BANK switching
2023-02-19 Start on python based assembler
2023-06-04 Update monitor to show drive letter
    [ALU_DataRegs.sch, Addressing.sch, Analog.sch, IR_Decode.sch, MemoryIO.sch, Schematic.kicad_pcb, Schematic.sch]
